floatAsNeeded/LineaMeteoStazione-Old-Version-/README.md

# LineaMeteoStazione (OLD VERSION, PLEASE REFER TO NEW VERSION HERE https://github.com/floatAsNeeded/LineaMeteoStazione-Personalised-Weather-Station)
LineaMeteoStazione is a complete weather station which can be interfaced with professional sensors from Sensirion as well as some Davis Instrument component (Rain Gauge, Anemometer) The project is aimed as DIY weather station but just requiring the assembly part, because the boards will already be given programmed by me as well as the complete PCB. The code and the eagles files will be shared Opensource for the people who wants to try to do it from the beginning or modify it! 

YOU CAN FIND THE WEATHER STATION IN WeatherCloud, Wunderground and LineaMeteo (Italian Weather network!) (Anemometer is not Installed)

https://app.weathercloud.net/d5032014112#profile

https://www.wunderground.com/dashboard/pws/IMELBO1836

http://www.lineameteo.it/stazioni.php?id=1857

https://thingspeak.com/channels/1109717

Please Note (The links above will go Offline because the weather station will be removed in February 2021 because I'm moving in an apartment)

YOU CAN FIND ALL THE INFO HERE IN GITHUB

# Consumption:

# Device 1 
19mA in average if upload time is 90 seconds.

# Device 3 
2mA in average if always updated automatically.
