floatAsNeeded/LineaMeteoStazione-Old-Version-/MANUALE LINEAMETEO STAZIONE (Italiano).pdf

1

# MANUALE LINEAMETEO STAZIONE

LineaMeteoStazione è una stazione meteorologica completa, interfacciabile con sensori professionali Sensirion e con alcuni componenti della strumentazione Davis (Pluviometro, Anemometro) Il progetto si propone come stazione meteorologica fai da te ma che richiede soltanto la parte di montaggio, perché le schede verranno già fornite da me programmate e così come il PCB completo. Il codice sarà condiviso opensource per le persone che vogliono provare a fare il progetto dall'inizio o modificarlo!

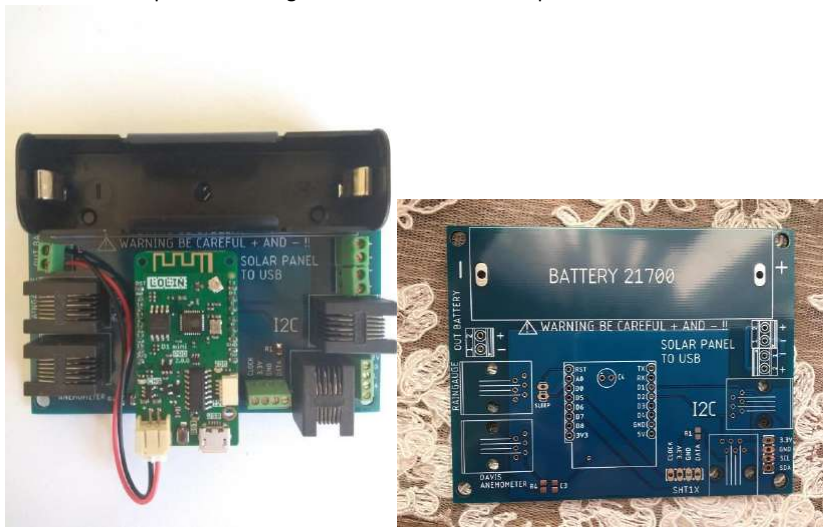
[picture p28: figure]

2

### Lista dei componenti

Funziona con una combinazione di schede di sviluppo ESP8266 ed ESP32 ed è composto principalmente da 3 dispositivi:

### 1. DISPOSITIVO 1: WEMOS D1 MINI PRO (nuova versione) + PCB progettato (da installare

ESTERNAMENTE) E PANNELLO SOLARE
Questa è la parte che sarà installata all'esterno e consiste in una scheda di sviluppo insieme con il PCB. Viene utilizzato per raccogliere i dati meteo che verranno inviati al Firebase di Google. I dati vengono raccolti in tempo reale da ogni sensore, ma il tempo di caricamento è selezionabile nelle impostazioni della stazione meteorologica di cui verrà spiegato meglio nel manuale in seguito. La temperatura massima e minima sono rilevate in tempo reale. Di seguito la foto dell'unità completa:

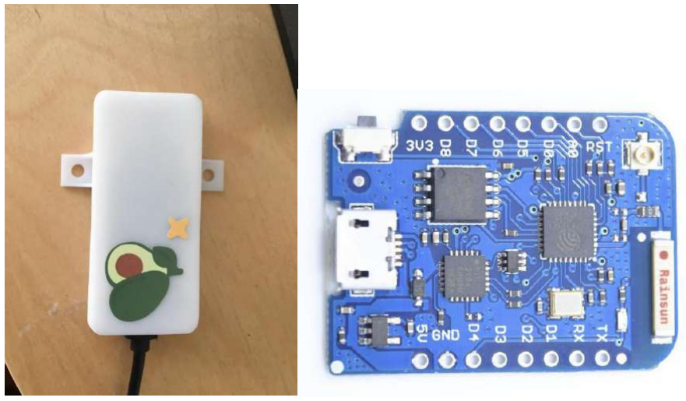
[picture p29: figure]

3

### 2. DISPOSITIVO 2: WEMOS D1 MINI PRO (vecchia versione) + BMP180

Questa è la parte che gestisce tutte le comunicazioni di rete e raccoglie anche i dati dal Firebase di Google. I compiti del DISPOSITIVO 2 consistono nel:

- Raccolta dei dati
- Condivisione di alcuni dati su un indirizzo IP in un formato pronto per essere utilizzato per comunicare con la rete meteo LineaMeteo.
- Possibilità di essere interfacciata con weathercloud
- Possibilità di essere interfacciata con wunderground
- Possibilità di essere interfacciata con ThingSpeak
- Sensore di pressione atmosferica

La scatola è stampata in 3D da https://www.thingiverse.com/thing:4081064

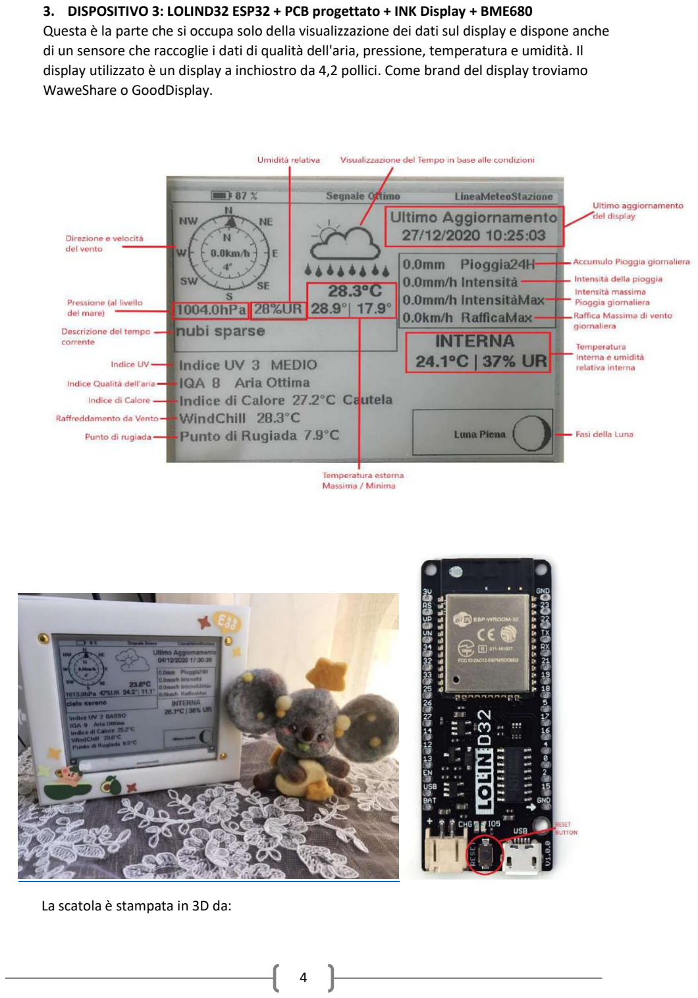
[picture p30: page 4]

4

### 3. DISPOSITIVO 3: LOLIND32 ESP32 + PCB progettato + INK Display + BME680

Questa è la parte che si occupa solo della visualizzazione dei dati sul display e dispone anche di un sensore che raccoglie i dati di qualità dell'aria, pressione, temperatura e umidità. Il display utilizzato è un display a inchiostro da 4,2 pollici. Come brand del display troviamo WaweShare o GoodDisplay.

La scatola è stampata in 3D da:


5

Box for ePaper + ESP32 Information Display by sidoh10 - Thingiverse (https://www.thingiverse.com/thing:2984559)

### SETTAGGIO STAZIONE METEO PASSO DOPO PASSO

DISPOSITIVO 2: Interfaccia con Wi-Fi e Firebase Google

Prima di tutto dobbiamo creare un account Firebase. Per farlo avrai bisogno di un account Google che puoi creare QUI (https://accounts.google.com/signup/v2/webcreateaccount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) se non ne hai già uno. Per configurare l'account Firebase segui i seguenti passaggi:

### 1. Vai su FIREBASE (https://firebase.google.com/) e clicca su ‘Get Started’

### 2. Accedi al tuo account di Google

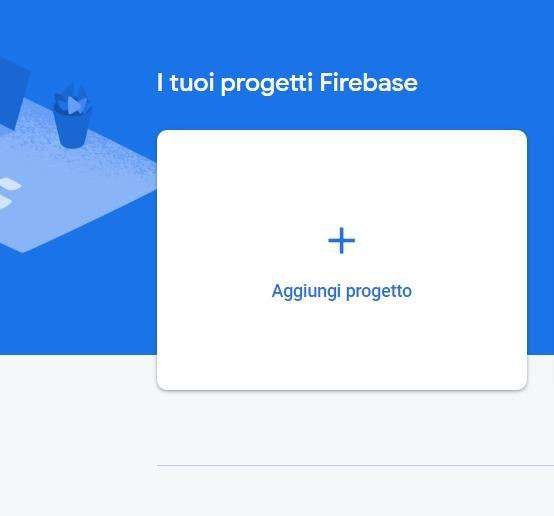
[picture p31: figure]
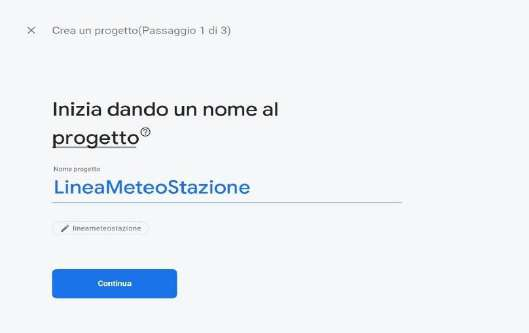
[picture p32: figure]

6

### 3. Clicca su ‘Add a project’ ‘Aggiungi progetto’

4. Dai un nome al tuo progetto! Clicca su ‘Continue’ ‘Continua’. Segui i passaggi e crea il progetto. Utilizza l'account predefinito per Firebase.

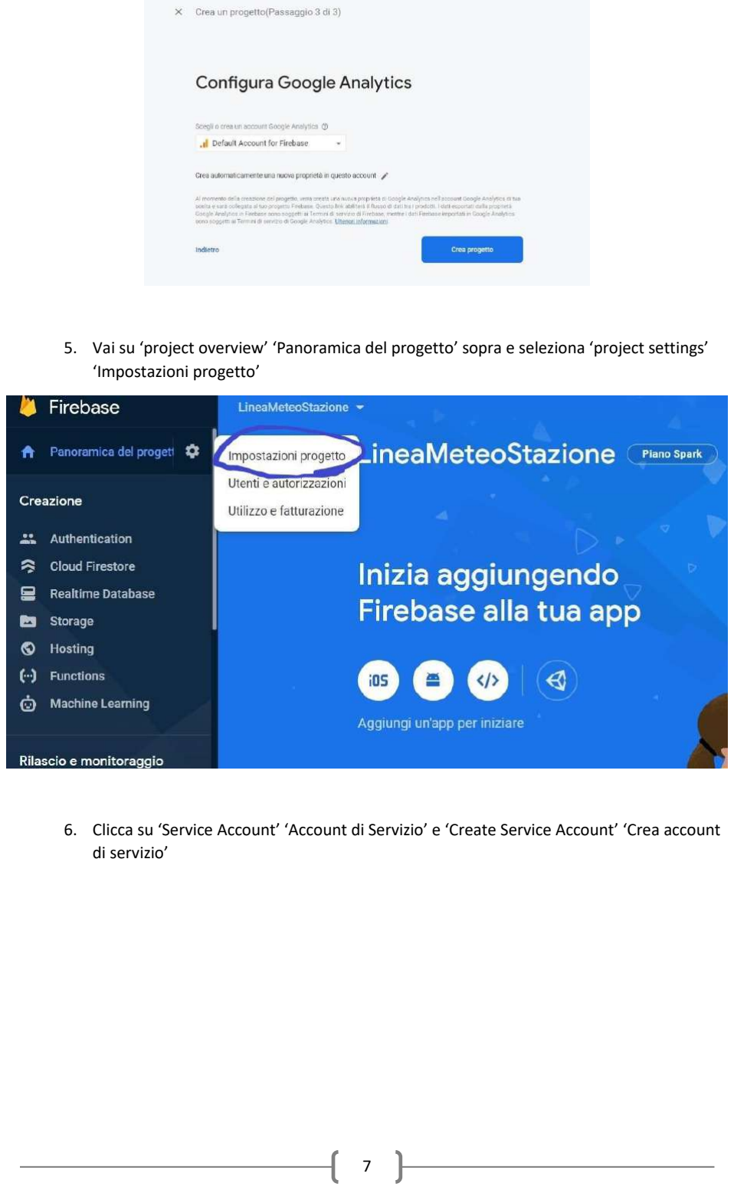
[picture p33: page 7]

7

5. Vai su ‘project overview’ ‘Panoramica del progetto’ sopra e seleziona ‘project settings’ ‘Impostazioni progetto’
6. Clicca su ‘Service Account’ ‘Account di Servizio’ e ‘Create Service Account’ ‘Crea account di servizio’

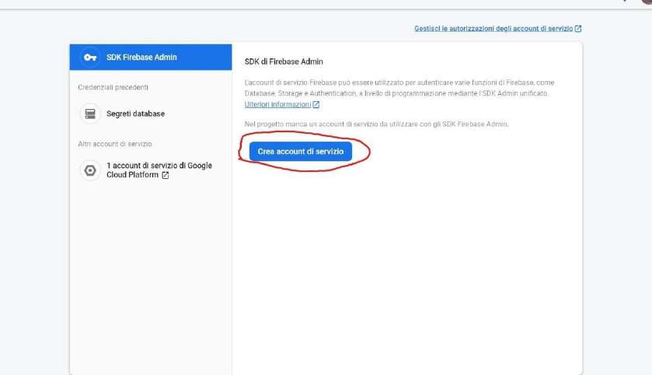
[picture p34: figure]

8

7. Torna a "Panoramica del progetto" e crea il database in tempo reale "Crea database", segui i passaggi e seleziona la posizione più vicina a te per il database.

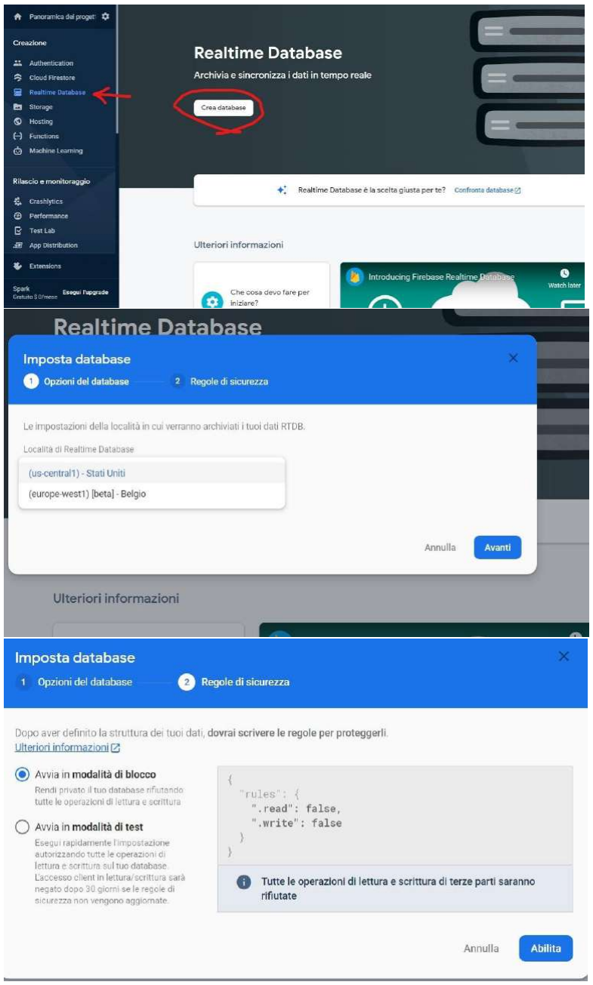
[picture p35: figure]

9

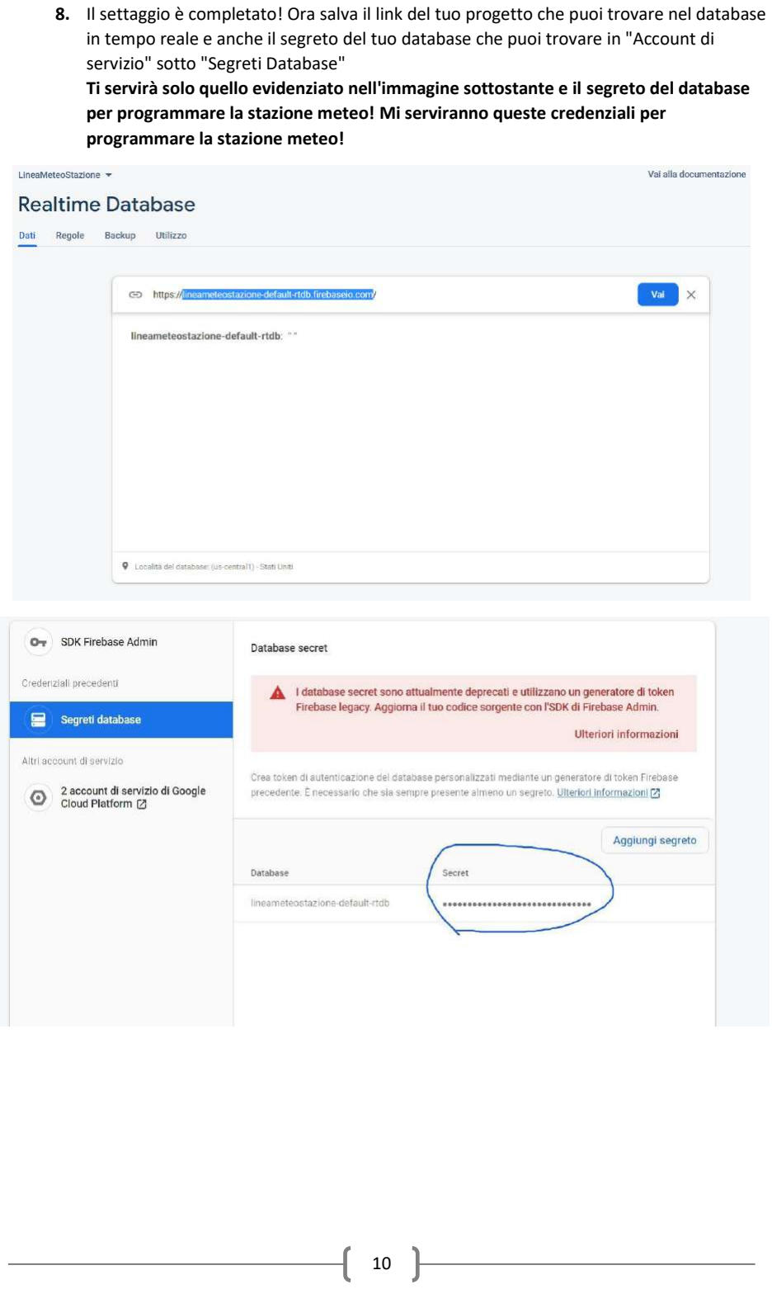
[picture p36: page 10]

10

8. Il settaggio è completato! Ora salva il link del tuo progetto che puoi trovare nel database in tempo reale e anche il segreto del tuo database che puoi trovare in "Account di servizio" sotto "Segreti Database"
Ti servirà solo quello evidenziato nell'immagine sottostante e il segreto del database per programmare la stazione meteo! Mi serviranno queste credenziali per programmare la stazione meteo!

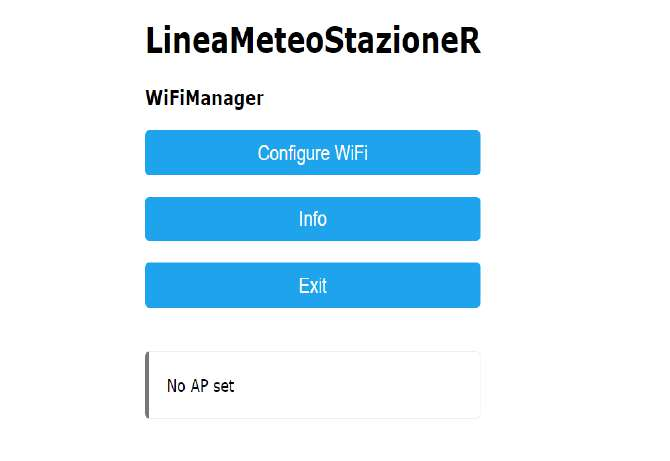
[picture p37: figure]

11

SETTAGGIO RETE WI-FI

Per configurare la connessione Wi-Fi, segui i seguenti passaggi:

- Collega il cavo USB dal DISPOSITIVO 2 a una porta USB (puoi utilizzare un normale caricabatterie per il tuo telefono o qualsiasi porta USB disponibile, ad esempio una porta sul router (opzione consigliata))
- Una volta acceso il DISPOSITIVO 2 lo troverai nelle connessioni Wi-Fi disponibili sul tuo smartphone o computer con il nome di LineaMeteoStazioneR.
- Prova a connetterti e ti chiederà la password. PASSWORD: LaMeteo2005 Dopo questo passaggio, ti mostrerà una pagina come questa:

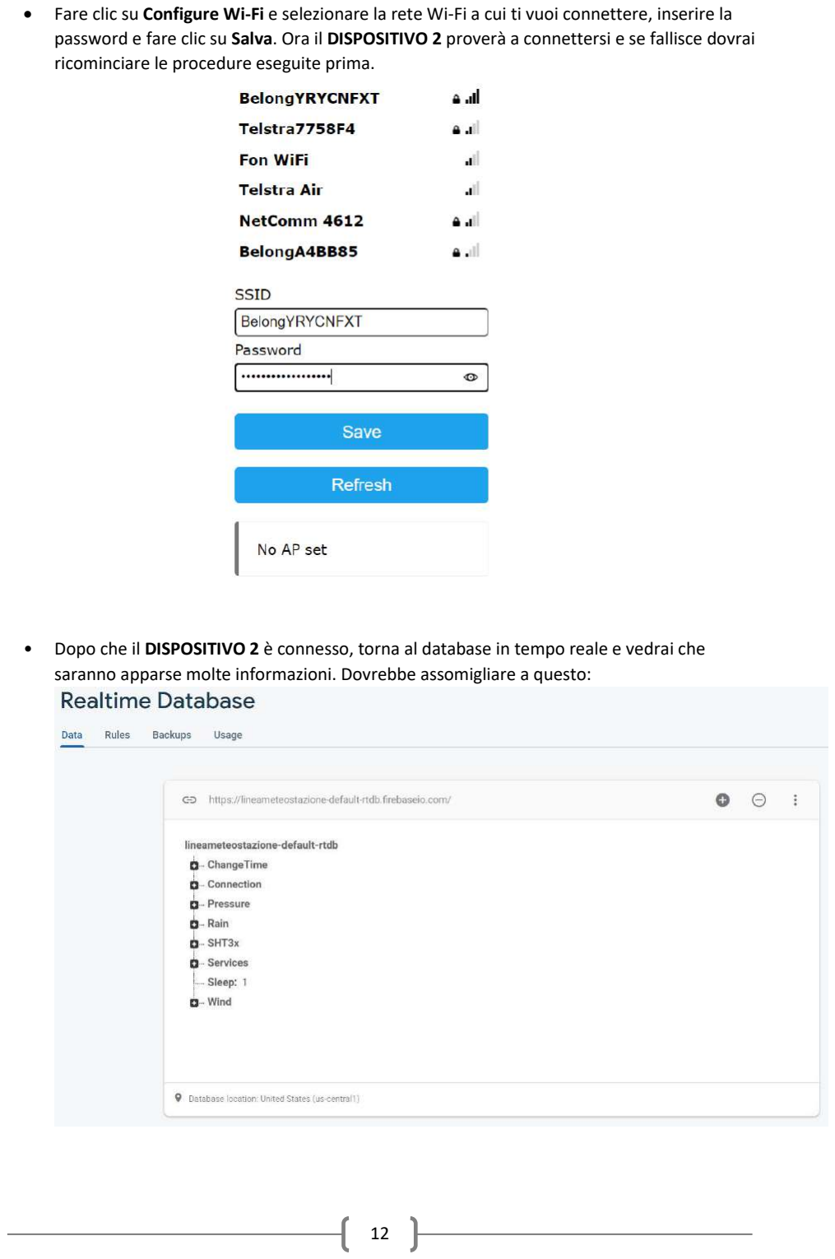
[picture p38: page 12]

12

- Fare clic su Configure Wi-Fi e selezionare la rete Wi-Fi a cui ti vuoi connettere, inserire la password e fare clic su Salva. Ora il DISPOSITIVO 2 proverà a connettersi e se fallisce dovrai ricominciare le procedure eseguite prima.
- Dopo che il DISPOSITIVO 2 è connesso, torna al database in tempo reale e vedrai che saranno apparse molte informazioni. Dovrebbe assomigliare a questo:

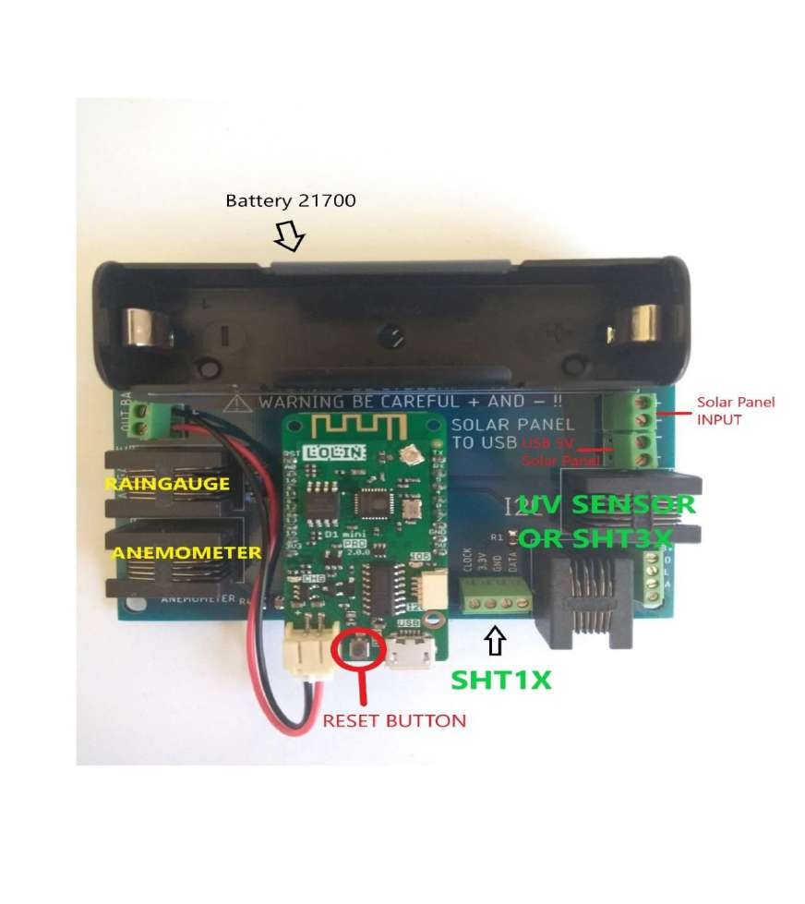
[picture p39: figure]

13

### Settaggio DISPOSITIVO 1(Esterno)

Questa è la parte dell'installazione della stazione meteorologica all'esterno. Per il sensore di temperatura e umidità esterno è necessario uno schermo solare. E inoltre richiesta una scatola stagna per una sicura installazione della batteria e del PCB.

PANORAMICA

Sotto puoi trovare una descrizione semplice della scheda:

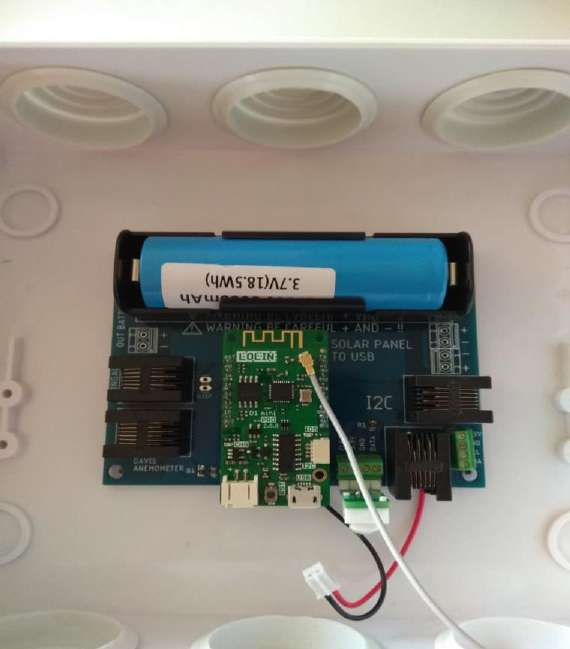
[picture p40: figure]

14

1. Installare la scheda in una scatola stagna come nell'esempio seguente e installare la batteria (FARE ATTENZIONE AL + E - E IN AGGIUNTA LA BATTERIA DEVE ESSERE CARICATA AL 100% PRIMA DEL PRIMO AVVIO):
2. Collegare tutti i sensori disponibili sulla scheda utilizzando i connettori RJ12, o usare il morsetto a vite a seconda del tipo di sensore utilizzato. (Fare riferimento all'elenco di "Sensori compatibili e specifiche” alla fine della guida) (I SENSORI SONO COLLEGATI CON

UNA SCHEDA ADATTATORE PROGETTATA SPECIFICAMENTE PER SHT3X E SENSORI UV E ANCHE UNO PER L’SHT35 SU TINDIE) (https://www.tindie.com/products/closedcube/sht35-d-digital-humidity-temperature-sensor/) VEDI FOTO

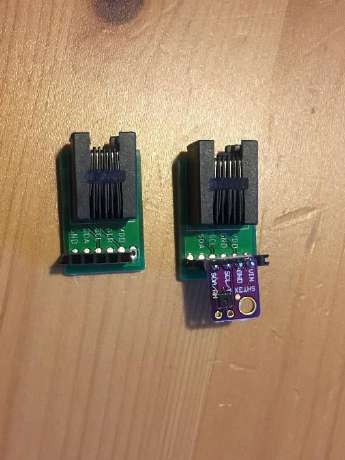
[picture p41: figure]


15

3. Collega il connettore della batteria al Wemos D1 Mini Pro e imposta la connessione Wi-Fi con gli stessi passaggi del DISPOSITIVO 2. Il nome sarà in questo caso "LineaMeteoStazioneS"

Successivamente collegare anche l'USB dal convertitore 5V del pannello solare. (La foto è solo rappresentativa di un prototipo e il convertitore USB sarà già collegato, ti basterà collegare il pannello solare)


16

### Configura le Impostazioni della Stazione Meteo tramite Firebase

OGNI IMPOSTAZIONE EFFETTUATA RICHIEDE DI SCOLLEGARE IL DISPOSITIVO 2 DALL’ ALIMENTAZIONE E RICOLLEGARLO ALL'ALIMENTAZIONE.

Dopo aver seguito le procedure sopra, scoprirai che il tuo database in tempo reale sarà simile a questo (se il sensore dell'indice UV è collegato, non mostrerà 655):

Il database è suddiviso nel seguente modo:

- ChangeTime
Questa opzione viene utilizzata per impostare il tuo fuso orario (TIMEZONE) che sarà poi corrispondente al tuo orario in automatico (è necessario modificarlo quando cambia l'ora legale e l’ora solare). Si può pure impostare il tempo di caricamento dei dati (SendDataTime). Si consiglia di non caricare i dati più velocemente di 90 secondi per risparmiare la durata della batteria del DISPOSITIVO 1. CurrentDay e RESETDATA non devono essere toccati. Per ripristinare tutti i dati nel database, digitate 0 in RESETDATA.

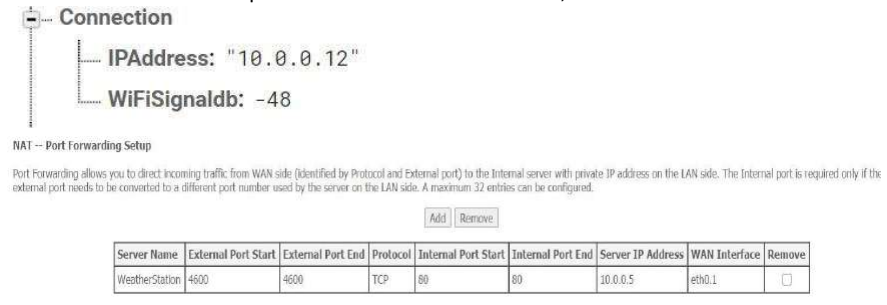
[picture p42: figure]

17

- Connection
Connection viene utilizzato per conoscere il tuo attuale indirizzo IP del DISPOSITIVO 2 e per monitorare la potenza del segnale Wi-Fi del DISPOSITIVO 1. Prova a mantenere il DISPOSITIVO 1 con almeno -75 o più di potenza del segnale.
IPAddress può essere utilizzato per il port forwarding dell'IP al fine di configurare i tuoi dispositivi nella rete meteo di LineaMeteo. (PortForwarding può essere eseguito nel router, ma ogni router è diverso, quindi devi conoscere il tuo modo per farlo. La porta esterna dovrebbe essere 4600 e la porta interna dovrebbe essere 80, come mostrato sotto.
- Pressure
Qui è memorizzato il valore della pressione ed è anche possibile calibrarlo in base al livello del mare. Fare riferimento a qualche stazione meteorologica vicina o guarda la pressione atmosferica attuale sulle previsioni. Ogni numero aggiunto significa 1Pa
- Rain
Qui viene memorizzato il valore della pioggia in 24H e anche altri valori relativi alla pioggia. Puoi utilizzare qualsiasi pluviometro a bascula, quindi questo significa che dovrai calibrare quanto ogni ribaltamento conta. Modificare "mmGoccia" per cambiare il conteggio di ribaltamento in mm. L'impostazione predefinita è 0,2 mm


18

- SHT1x
Contiene i dati della serie Sensirion SHT1x o SHT7x.
- SHT3x
Contiene i dati della serie Sensirion SHT3x.
- Services
Contiene tutti i servizi disponibili per l'utilizzo con questa stazione meteorologica.

OPENWEATHER
Puoi configurare il tuo account su OpenWeather (https://openweathermap.org/) per la descrizione delle condizioni meteorologiche attuali su DISPOSITIVO 3 (trova le my API key e copialo nell'API in Services, OpenWeather.) Digitare north se vivi nell'emisfero settentrionale o south nell'emisfero meridionale per visualizzare la sezione astronomica correttamente sul display. Lingua "en" o "it" per passare dall'inglese all'italiano su DEVICE 3. Latitudine e longitudine vanno inserite per visualizzare la descrizione corretta delle condizioni meteorologiche sul DISPOSITIVO 3

THINGSPEAK
Crea un account su ThingSpeak (https://thingspeak.com/) e trova la tu WriteAPIkey e copiala su myWriteAPIKey, per vedere la differenza con grafici tra le serie SHT1x e SHT3x se sono collegati i 2 sensori o per monitorare semplicemente l’SHT1x

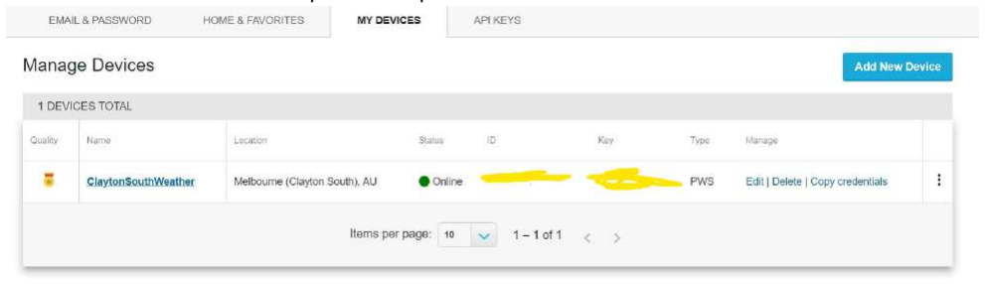
[picture p43: figure]

19

WeatherCloud
È possibile collegare la stazione meteorologica alla rete Weather Cloud utilizzando questa opzione. Vai su Impostazioni sui tuoi dispositivi e seleziona "Link", ti darà l'ID e la chiave che puoi copiare nel database.

WunderGround
È possibile collegare la stazione meteorologica a WunderGround utilizzando questa opzione. Trova l'ID e la chiave su I miei dispositivi e copialo nel database.
- Sleep
Per impostazione predefinita è impostato su 1 ma può essere modificato su 0 per abilitare la modalità di sospensione. In modalità sleep, il pluviometro e l'anemometro non funzionano, quindi devono essere scollegati dal PCB. La modalità sleep se utilizzata, la batteria durerà in media 6 mesi senza pannello solare.
- UVIndex
Questo contiene il valore dell'attuale UVindex.
- Wind
Questo contiene i valori del vento, come i gradi della direzione del vento e anche la velocità del vento e la raffica massima di vento. Può essere regolato l'offset qui, in modo da indicare la giusta direzione della direzione del vento. 0 gradi o 360 gradi dovrebbero essere corrispondenti al nord.

### SETTAGGIO DISPOSITIVO 3 DISPLAY

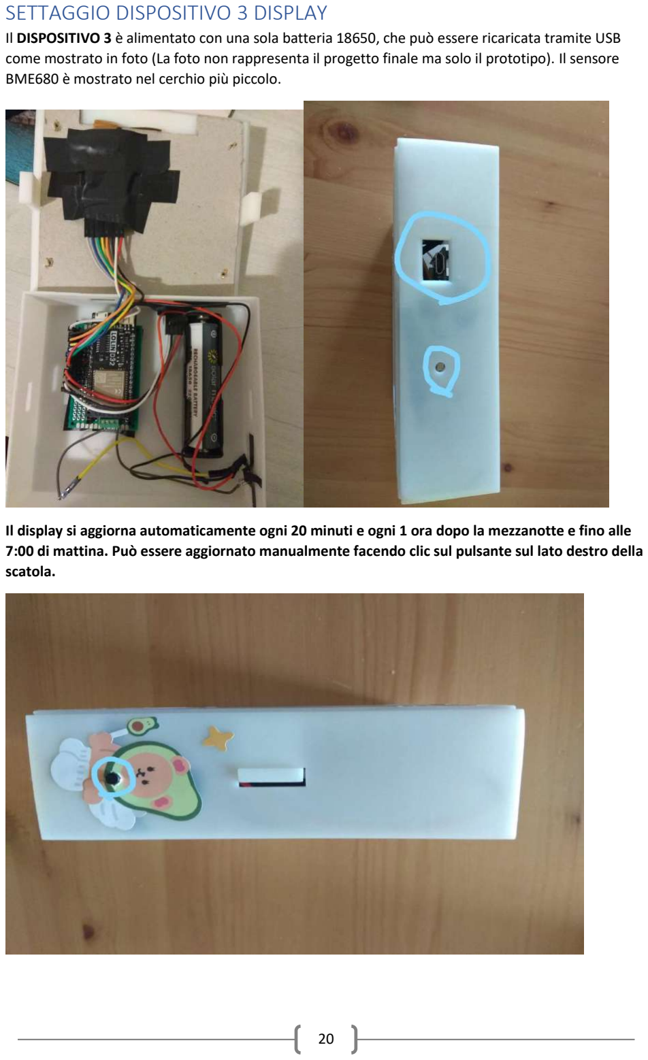
[picture p44: page 20]

20

Il DISPOSITIVO 3 è alimentato con una sola batteria 18650, che può essere ricaricata tramite USB come mostrato in foto (La foto non rappresenta il progetto finale ma solo il prototipo). Il sensore BME680 è mostrato nel cerchio più piccolo.

Il display si aggiorna automaticamente ogni 20 minuti e ogni 1 ora dopo la mezzanotte e fino alle 7:00 di mattina. Può essere aggiornato manualmente facendo clic sul pulsante sul lato destro della scatola.

21

Dopo che la batteria è stata installata, seguire le stesse procedure del DISPOSITIVO 2 per connettersi al Wi-Fi. Il nome della rete sarà "LineaMeteoStazioneVisual" La batteria deve essere sufficientemente carica prima dell'avvio.

### Sensori Compatibili

- Temperatura/Umidità PRINCIPALE: Serie SHT3x Sensirion. Precisione riferirsi al datasheet (https://www.sensirion.com/fileadmin/user_upload/customers/sensirion/Dokumente/2_Humidity_Sensors/Datasheets/Sensirion_Humidity_Sensors_SHT3x_Datasheet_digital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) di ogni sensore.
- Temperatura/Umidità SECONDARIO (può essere utilizzato per la temperatura del suolo e umidità) : SHT1x (https://www.sparkfun.com/datasheets/Sensors/SHT1x_datasheet.pdf) e SHT7x (https://www.mouser.com/datasheet/2/682/Sensirion_Humidity_SHT7x_Datasheet_V5-469726.pdf) serie Sensirion. Per la precision riferirsi al datasheet di ogni sensore.
- Temperature, Umidità e qualità dell’aria Interna: BME680 (https://cdn-shop.adafruit.com/product-files/3660/BME680.pdf)
- Pressione: BMP180 (https://cdn-shop.adafruit.com/datasheets/BST-BMP180-DS000-09.pdf)
- Pluviometro: Tutti i pluviometro a bascula, risoluzione modificabile. UNA VOLTA REGOLATA LA RISOLUZIONE, POTREBBERO NECESSARIE FINO A 3 ORE PER AGGIORNARE LE IMPOSTAZIONI SUL DISPOSITIVO 1. Questo perché il dispositivo va in sleepmode ogni 3 ore per risparmiare energia se non viene rilevata nessuna precipitazione. Quando si sveglia, controlla di nuovo le attuali impostazioni. Puoi anche resettare manualmente facendo clic sul pulsante di RESET come mostrato nella foto precedenti.
- Anemometro: Anemometro Davis
- UVIndex: SI1145 (https://cdn-shop.adafruit.com/datasheets/Si1145-46-47.pdf)

### Specifiche

- Batteria DISPOSITIVO 1: 3.7V 21700 Batteria al Litio (Consigliata 5000mAh)(Autonomia senza sole 8 giorni*)
ATTENZIONE: fare attenzione con le batteria al litio ad alte temperature (più di 45°C). La scatola stagna dovrebbe essere messa all'ombra. Inoltre, se temperature negativa di -10°C si verificano spesso o una condizione inferiore a 0°C persiste a lungo o si verifica una temperatura estremamente negativa (esempio -20°C), sarà necessaria una batteria specifica per le temperature estremamente fredde. In questo caso il PCB dovrà essere modificato per una batteria 18650 resistente al freddo -40°C con capacità inferiore (2900 mAh). L'autonomia senza sole sarà di 5 giorni.

* Senza sole significa in completa oscurità, una giornata nuvolosa non significa nessuna energia solare, ma allo stesso tempo non può essere considerata una giornata di sole.

22

- Batteria DISPOSITIVO 3: 3.7V 18650 Batteria al litio (Consigliata 3000mAh)
- Pannello solare 6-20V (6V fortemente consigliato)

Watt del pannello solare variano in relazione al tuo posizione che puoi controllare su Global Solar Atlas. (https://globalsolaratlas.info/map?s=42.572305,13.271484&m=site&c=42.563982,0.421874,4) Con meno di 1500 kWh / m2 la stazione meteorologica non può funzionare autonomamente. Se si utilizza la modalità sleep, sarebbe sufficiente un pannello solare più piccolo del minimo consigliato.

GTI opta per day | Less than 2000kWh/m2 and 1500kWh/m2 | 10W (minimum)
GTI opta per day | 2000kWh/m2 | 6W (minimum)
GTI opta per day | 2500kWh/m2 | 6W (minimum)
GTI opta per day | 3000kWh/m2 | 4.5W (minimum)
GTI opta per day | 3500kWh/m2 | 3.5W (minimum)
GTI opta per day | 4000kWh/m2 | 3W (minimum)
GTI opta per day | 4500kWh/m2 | 3W (minimum)
GTI opta per day | 5000kWh/m2 | 2.5W (minimum)
GTI opta per day | 5500kWh/m2 or more | 2W (minimum)
- La lunghezza del cavo per la serie SHT3x non deve superare i 3 m
- La lunghezza del cavo per le serie SHT1x e SHT7x non deve superare i 10 m

### Risoluzione dei problemi

- Se uno dei DISPOSITIVI non funziona come previsto, sarà necessario un RESET. Rimuovere il connettore della batteria o rimuovere la batteria e riavviare il dispositivo se RESET non dovesse funzionare. Per il DISPOSITIVO 1, inserire SEMPRE prima la batteria e poi il connettore del pannello solare.
- Se il DISPOSITIVO 3 mostra il 100% durante la ricarica, per il momento è normale, perché la scheda non ha un IC specifico per lo stato di carica, quindi è influenzata dalla resistenza interna della cella.
- Altre domande riguardo a problemi, contattami in privato!

### CONTATTI

Per discutere su come ordinare la stazione meteorologica o sulle risorse disponibili, scrivetemi sulla mia email Eugenio eugenioiaquinta@outlook.it

LineaMeteo topic forum:

Strumenti meteo :: Stazione Meteo Completa WiFi Con ESP8266 E ESP32 E Arduino! (lineameteo.it) (http://www.lineameteo.it/stazione-meteo-completa-wifi-con-esp8266-e-esp32-e-arduino-vt17685.html)

Instructables

Professional Weather Station Using ESP8266 and ESP32 DIY : 9 Steps (with Pictures) - Instructables (https://www.instructables.com/Professional-Weather-Station-Using-ESP8266-and-ESP/)

GitHubLINK (https://github.com/floatAsNeeded/LineaMeteoStazione)
