floatAsNeeded/LineaMeteoStazione-Old-Version-/(commit log)

2021-01-01 Update LineaMeteoStazioneR.ino
    Added pressure sensor DEVICE 2
2021-01-01 Update LineaMeteoStazioneR.ino
    Added pressure sensor to DEVICE 2
